5418XR/Wireless-Sensor-Node/(commit log)

2022-03-15 just the demo for pwm
2022-04-15 add the power saving code
2022-04-16 fix the bug of sleeping, it is working now.
    [WSN_rongx.ino.ino, bluetooth.ino]
2022-04-26 lower power mode update
